Songgggggggg/FinalProject/(list of files, drawings)

Other design files:
PCB-0815.dip
