Songgggggggg/FinalProject/1_nrst.kicad_sch

## KiCad design 1_nrst.kicad_sch (2023-09-04)

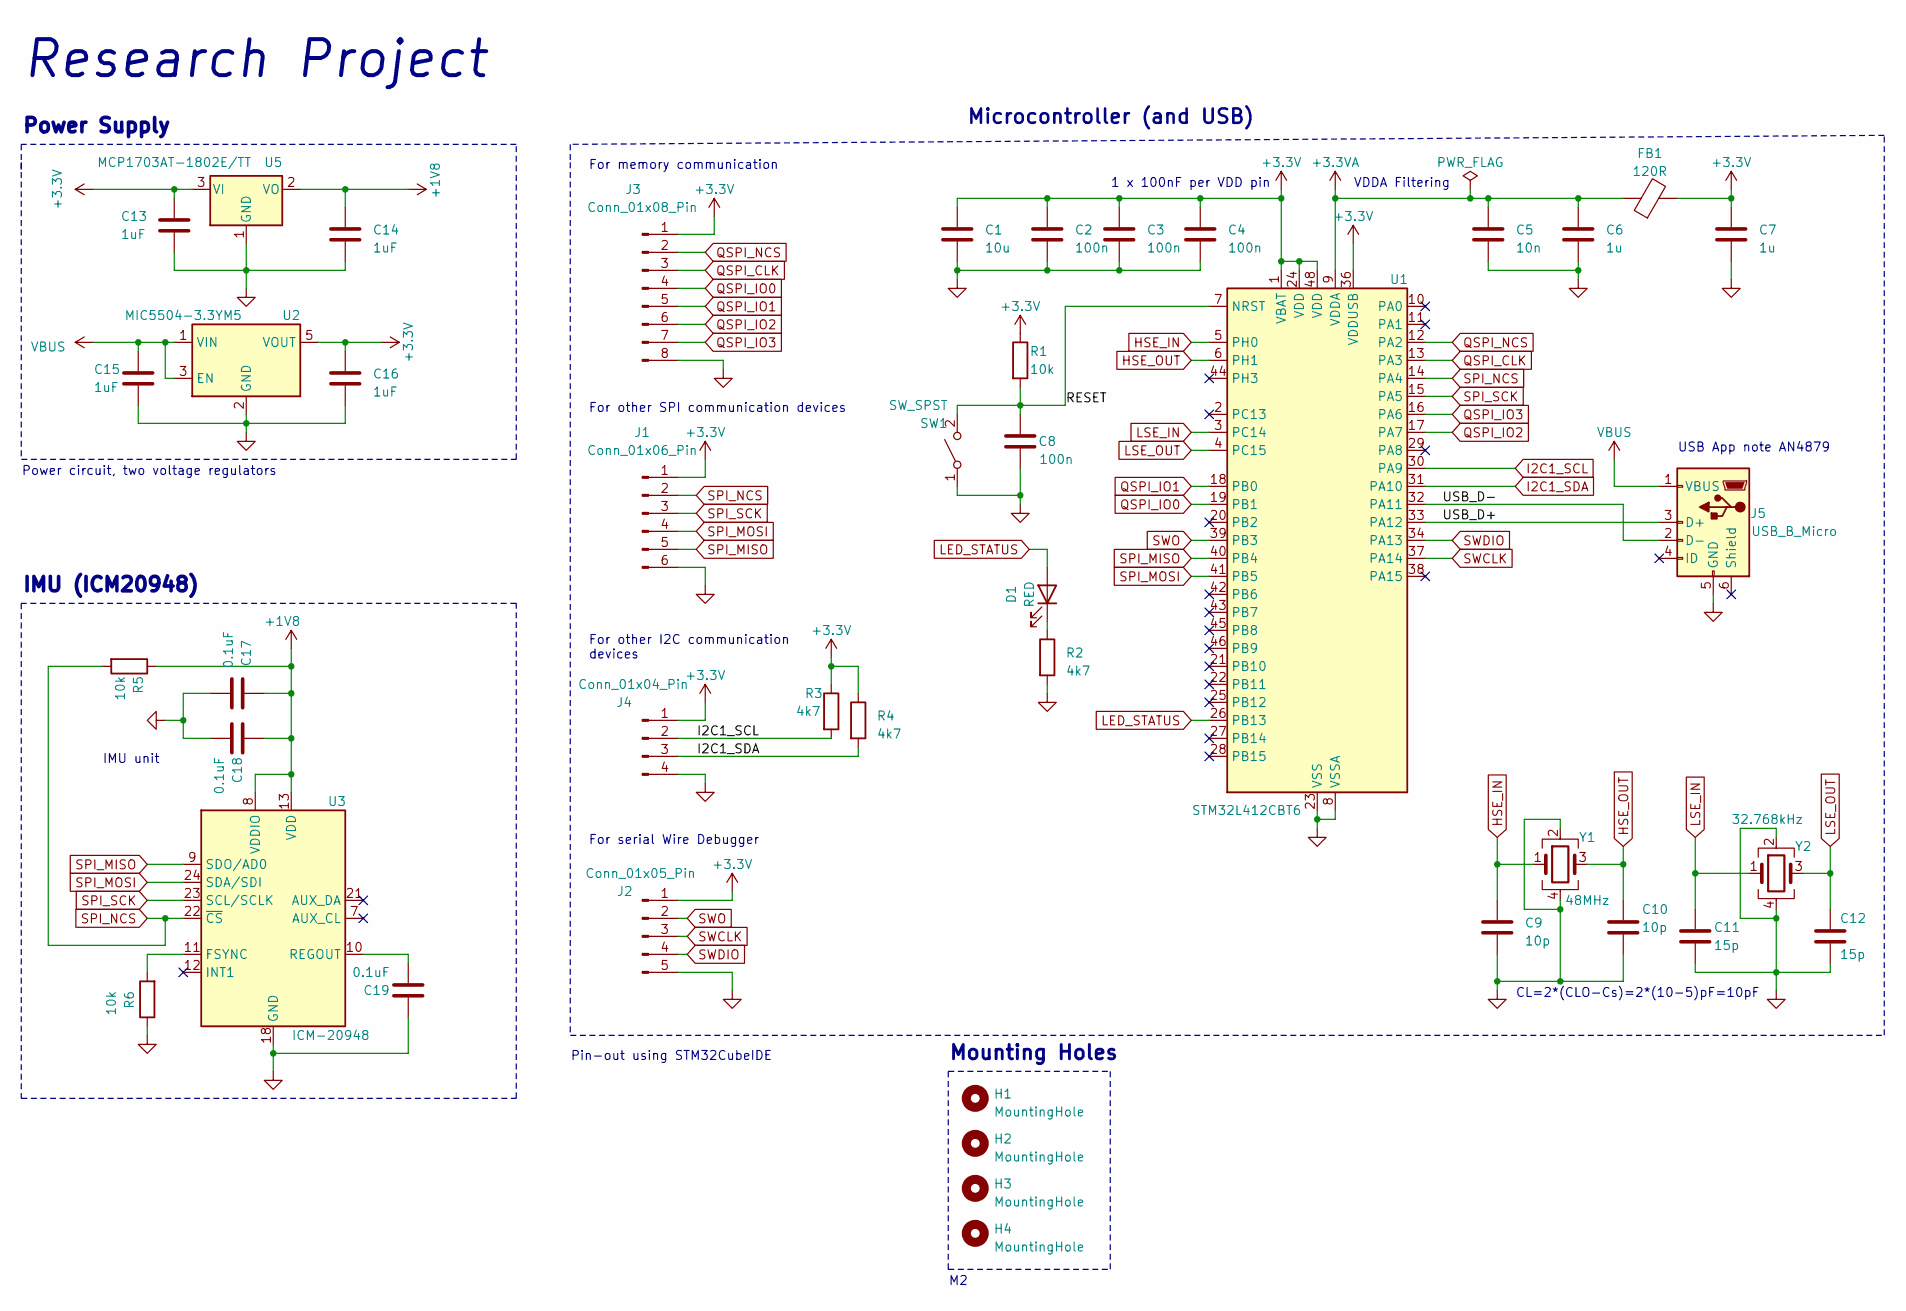
[picture p13: schematic 1_nrst.kicad_sch]

Parts:
C1: 10u; C_0603_1608Metric
C2, C3, C4, C8: 100n; C_0402_1005Metric
C5: 10n; C_0402_1005Metric
C6, C7: 1u; C_0402_1005Metric
C9, C10: 10p; C_0402_1005Metric
C11, C12: 15p; C_0402_1005Metric
C13, C14, C15, C16: 1uF; C_0805_2012Metric
C17, C18, C19: 0.1uF; C_0805_2012Metric
D1: RED; LED_0402_1005Metric
FB1: 120R; L_0603_1608Metric
H1, H2, H3, H4: MountingHole; MountingHole_2.2mm_M2
J1: Conn_01x06_Pin; PinHeader_1x06_P2.54mm_Vertical
J2: Conn_01x05_Pin; PinHeader_1x05_P2.54mm_Vertical
J3: Conn_01x08_Pin; PinHeader_1x08_P2.54mm_Vertical
J4: Conn_01x04_Pin; PinHeader_1x04_P2.54mm_Vertical
J5: USB_B_Micro; USB_Micro-B_Wuerth_629105150521
R1, R5, R6: 10k; R_0402_1005Metric
R2, R3, R4: 4k7; R_0402_1005Metric
SW1: SW_SPST; SW_SPST_PTS645
U1: STM32L412CBT6; LQFP-48_7x7mm_P0.5mm
U2: MIC5504-3.3YM5; SOT-23-5
U3: ICM-20948; InvenSense_QFN-24_3x3mm_P0.4mm
U5: MCP1703AT-1802E/TT; SOT-23
Y1: 48MHz; Crystal_SMD_3225-4Pin_3.2x2.5mm
Y2: 32.768kHz; Crystal_SMD_3225-4Pin_3.2x2.5mm

Connections:
+1V8: C14.1, C17.1, C18.1, R5.1, U3.8 (VDDIO), U3.13 (VDD), U5.2 (VO)
+3.3V: C1.1, C2.1, C3.1, C4.1, C7.1, C13.1, C16.1, FB1.2, J1.1, J2.1, J3.1, J4.1, R1.1, R3.1, R4.1, U1.1 (VBAT), U1.24 (VDD), U1.36 (VDDUSB), U1.48 (VDD), U2.5 (VOUT), U5.3 (VI)
+3.3VA: C5.1, C6.1, FB1.1, U1.9 (VDDA)
GND: C1.2, C2.2, C3.2, C4.2, C5.2, C6.2, C7.2, C8.2, C9.2, C10.2, C11.2, C12.2, C13.2, C14.2, C15.2, C16.2, C17.2, C18.2, C19.1, J1.6, J2.5, J3.8, J4.4, J5.5 (GND), R2.2, R6.1, SW1.1 (A), U1.8 (VSSA), U1.23 (VSS), U1.35 (VSS), U1.47 (VSS), U2.2 (GND), U3.18 (GND), U3.20 (GND), U5.1 (GND), Y1.2, Y1.4, Y2.2, Y2.4
HSE_IN: C9.1, U1.5 (PH0), Y1.1
HSE_OUT: C10.1, U1.6 (PH1), Y1.3
I2C1_SCL: J4.2, R3.2, U1.30 (PA9)
I2C1_SDA: J4.3, R4.2, U1.31 (PA10)
LED_STATUS: D1.2 (A), U1.26 (PB13)
LSE_IN: C11.1, U1.3 (PC14), Y2.1
LSE_OUT: C12.1, U1.4 (PC15), Y2.3
unnamed: C19.2, U3.10 (REGOUT)
unnamed: D1.1 (K), R2.1
unnamed: R6.2, U3.11 (FSYNC)
QSPI_CLK: J3.3, U1.13 (PA3)
QSPI_IO0: J3.4, U1.19 (PB1)
QSPI_IO1: J3.5, U1.18 (PB0)
QSPI_IO2: J3.6, U1.17 (PA7)
QSPI_IO3: J3.7, U1.16 (PA6)
QSPI_NCS: J3.2, U1.12 (PA2)
RESET: C8.1, R1.2, SW1.2 (B), U1.7 (NRST)
SPI_MISO: J1.5, U1.40 (PB4), U3.9 (SDO/AD0)
SPI_MOSI: J1.4, U1.41 (PB5), U3.24 (SDA/SDI)
SPI_NCS: J1.2, R5.2, U1.14 (PA4), U3.22 (~CS)
SPI_SCK: J1.3, U1.15 (PA5), U3.23 (SCL/SCLK)
SWCLK: J2.3, U1.37 (PA14)
SWDIO: J2.4, U1.34 (PA13)
SWO: J2.2, U1.39 (PB3)
USB_D+: J5.3 (D+), U1.33 (PA12)
USB_D-: J5.2 (D-), U1.32 (PA11)
VBUS: C15.1, J5.1 (VBUS), U2.1 (VIN), U2.3 (EN)

Notes on the sheet:
CL=2*(CLO-Cs)=2*(10-5)pF=10pF
For serial Wire Debugger
For memory communication
Research Project
Power circuit, two voltage regulators
USB App note AN4879
For other SPI communication devices
1 x 100nF per VDD pin
Pin-out using STM32CubeIDE
IMU unit
VDDA Filtering
Mounting Holes
Microcontroller (and USB)
IMU (ICM20948)
Power Supply
For other I2C communication devices
