Songgggggggg/FinalProject/Wearable_IMU_Device/MX25QL512/MX25QL512.ioc

Mcu.UserName=STM32L412RBTxP
PA10.Signal=I2C1_SDA
PA11.Signal=USB_DM
PA12.Signal=USB_DP
PA2.Signal=QUADSPI_BK1_NCS
PA3.Signal=QUADSPI_CLK
PA4.GPIO_Label=SPI1_CS
PA4.Signal=GPIO_Output
PA5.Signal=SPI1_SCK
PA6.Signal=QUADSPI_BK1_IO3
PA7.Signal=QUADSPI_BK1_IO2
PA9.Signal=I2C1_SCL
PB0.Signal=QUADSPI_BK1_IO1
PB1.Signal=QUADSPI_BK1_IO0
PB13.GPIO_Label=LED
PB13.Signal=GPIO_Output
PB5.Signal=SPI1_MOSI
