Songgggggggg/FinalProject/Wearable_IMU_Device/MX25QL512/Core/Src/quadspi.c

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
/* Includes ------------------------------------------------------------------*/
#include "quadspi.h"

/* USER CODE BEGIN 0 */
static uint8_t QSPI_WriteEnable(void);
static uint8_t QSPI_AutoPollingMemReady(uint32_t Timeout);
static uint8_t QSPI_Configuration(void);
static uint8_t QSPI_ResetChip(void);
/* USER CODE END 0 */

QSPI_HandleTypeDef hqspi;

/* QUADSPI init function */
void MX_QUADSPI_Init(void)
{

  hqspi.Instance = QUADSPI;
  hqspi.Init.ClockPrescaler = 0;
  hqspi.Init.FifoThreshold = 4;
  hqspi.Init.SampleShifting = QSPI_SAMPLE_SHIFTING_HALFCYCLE;
  hqspi.Init.FlashSize = 25;
  hqspi.Init.ChipSelectHighTime = QSPI_CS_HIGH_TIME_1_CYCLE;
  hqspi.Init.ClockMode = QSPI_CLOCK_MODE_0;
  hqspi.Init.FlashID = QSPI_FLASH_ID_1;
  hqspi.Init.DualFlash = QSPI_DUALFLASH_DISABLE;
  if (HAL_QSPI_Init(&hqspi) != HAL_OK)
  {
    Error_Handler();
  }
}

void HAL_QSPI_MspInit(QSPI_HandleTypeDef* qspiHandle)
{

  GPIO_InitTypeDef GPIO_InitStruct = {0};
  if(qspiHandle->Instance==QUADSPI)
  {
    /* QUADSPI clock enable */
    __HAL_RCC_QSPI_CLK_ENABLE();

    __HAL_RCC_GPIOA_CLK_ENABLE();
    __HAL_RCC_GPIOB_CLK_ENABLE();
    /**QUADSPI GPIO Configuration
    PA2     ------> QUADSPI_BK1_NCS
    PA3     ------> QUADSPI_CLK
    PA6     ------> QUADSPI_BK1_IO3
    PA7     ------> QUADSPI_BK1_IO2
    PB0     ------> QUADSPI_BK1_IO1
    PB1     ------> QUADSPI_BK1_IO0
    */
    GPIO_InitStruct.Pin = GPIO_PIN_2|GPIO_PIN_3|GPIO_PIN_6|GPIO_PIN_7;
    GPIO_InitStruct.Mode = GPIO_MODE_AF_PP;
    GPIO_InitStruct.Pull = GPIO_NOPULL;
    GPIO_InitStruct.Speed = GPIO_SPEED_FREQ_VERY_HIGH;
    GPIO_InitStruct.Alternate = GPIO_AF10_QUADSPI;
    HAL_GPIO_Init(GPIOA, &GPIO_InitStruct);

    GPIO_InitStruct.Pin = GPIO_PIN_0|GPIO_PIN_1;
    GPIO_InitStruct.Mode = GPIO_MODE_AF_PP;
    GPIO_InitStruct.Pull = GPIO_NOPULL;
    GPIO_InitStruct.Speed = GPIO_SPEED_FREQ_VERY_HIGH;
    GPIO_InitStruct.Alternate = GPIO_AF10_QUADSPI;
    HAL_GPIO_Init(GPIOB, &GPIO_InitStruct);

  }
}

void HAL_QSPI_MspDeInit(QSPI_HandleTypeDef* qspiHandle)
{

  if(qspiHandle->Instance==QUADSPI)
  {
    /* Peripheral clock disable */
    __HAL_RCC_QSPI_CLK_DISABLE();

    /**QUADSPI GPIO Configuration
    PA2     ------> QUADSPI_BK1_NCS
    PA3     ------> QUADSPI_CLK
    PA6     ------> QUADSPI_BK1_IO3
    PA7     ------> QUADSPI_BK1_IO2
    PB0     ------> QUADSPI_BK1_IO1
    PB1     ------> QUADSPI_BK1_IO0
    */
    HAL_GPIO_DeInit(GPIOA, GPIO_PIN_2|GPIO_PIN_3|GPIO_PIN_6|GPIO_PIN_7);

    HAL_GPIO_DeInit(GPIOB, GPIO_PIN_0|GPIO_PIN_1);

  }
}

/* USER CODE BEGIN 1 */


/* QUADSPI init function */
uint8_t
CSP_QUADSPI_Init(void) {
    //prepare QSPI peripheral for ST-Link Utility operations
	hqspi.Instance = QUADSPI;
    if (HAL_QSPI_DeInit(&hqspi) != HAL_OK) {
        return HAL_ERROR;
    }

    MX_QUADSPI_Init();

    if (QSPI_ResetChip() != HAL_OK) {
        return HAL_ERROR;
    }

    HAL_Delay(1);

    if (QSPI_AutoPollingMemReady(HAL_QPSI_TIMEOUT_DEFAULT_VALUE) != HAL_OK) {
        return HAL_ERROR;
    }

    if (QSPI_WriteEnable() != HAL_OK) {

        return HAL_ERROR;
    }

    if (QSPI_Configuration() != HAL_OK) {
        return HAL_ERROR;
    }

    if (QSPI_AutoPollingMemReady(HAL_QPSI_TIMEOUT_DEFAULT_VALUE) != HAL_OK) {
        return HAL_ERROR;
    }

    return HAL_OK;
}


/**
  * @brief Erases the entire QSPI chip.
  * @return HAL_OK if the operation is successful, otherwise HAL_ERROR.
  */
uint8_t CSP_QSPI_Erase_Chip(void) {
    QSPI_CommandTypeDef sCommand; // Structure to define commands for the QSPI.

    // Enable writing to the QSPI.
    if (QSPI_WriteEnable() != HAL_OK) {
        return HAL_ERROR;
    }

    // Setting up the erasing sequence.
    sCommand.Instruction = CHIP_ERASE_CMD; // Chip erase command.
    sCommand.InstructionMode = QSPI_INSTRUCTION_1_LINE; // Use one line for the instruction.
    sCommand.AddressSize = QSPI_ADDRESS_32_BITS; // Address size is 32 bits.
    sCommand.AlternateByteMode = QSPI_ALTERNATE_BYTES_NONE; // No alternate bytes.
    sCommand.DdrMode = QSPI_DDR_MODE_DISABLE; // DDR mode is disabled.
    sCommand.DdrHoldHalfCycle = QSPI_DDR_HHC_ANALOG_DELAY; // Hold half cycle.
    sCommand.SIOOMode = QSPI_SIOO_INST_EVERY_CMD; // Send instruction on every command.
    sCommand.AddressMode = QSPI_ADDRESS_NONE; // No address.
    sCommand.Address = 0; // No specific address.
    sCommand.DataMode = QSPI_DATA_NONE; // No data.
    sCommand.DummyCycles = 0; // No dummy cycles.

    // Send the command to erase the chip.
    if (HAL_QSPI_Command(&hqspi, &sCommand, HAL_QPSI_TIMEOUT_DEFAULT_VALUE) != HAL_OK) {
        return HAL_ERROR;
    }

    // Check and wait until the memory is ready after erasing.
    if (QSPI_AutoPollingMemReady(QUADSPI_MAX_ERASE_TIMEOUT) != HAL_OK) {
        return HAL_ERROR;
    }

    return HAL_OK;
}


static uint8_t
QSPI_AutoPollingMemReady(uint32_t Timeout) {

    QSPI_CommandTypeDef sCommand;
    QSPI_AutoPollingTypeDef sConfig;

    /* Configure automatic polling mode to wait for memory ready ------ */
    sCommand.InstructionMode = QSPI_INSTRUCTION_1_LINE;
    sCommand.Instruction = READ_STATUS_REG_CMD;
    sCommand.AddressMode = QSPI_ADDRESS_NONE;
    sCommand.AlternateByteMode = QSPI_ALTERNATE_BYTES_NONE;
    sCommand.DataMode = QSPI_DATA_1_LINE;
    sCommand.DummyCycles = 0;
    sCommand.DdrMode = QSPI_DDR_MODE_DISABLE;
    sCommand.DdrHoldHalfCycle = QSPI_DDR_HHC_ANALOG_DELAY;
    sCommand.SIOOMode = QSPI_SIOO_INST_EVERY_CMD;

    sConfig.Match = 0x0000;
    sConfig.Mask = 0x0101;
    sConfig.MatchMode = QSPI_MATCH_MODE_AND;
    sConfig.StatusBytesSize = 2;
    sConfig.Interval = 0x10;
    sConfig.AutomaticStop = QSPI_AUTOMATIC_STOP_ENABLE;

    if (HAL_QSPI_AutoPolling(&hqspi, &sCommand, &sConfig, Timeout) != HAL_OK) {
        return HAL_ERROR;
    }

    return HAL_OK;
}

static uint8_t
QSPI_WriteEnable(void) {
    QSPI_CommandTypeDef sCommand;
    QSPI_AutoPollingTypeDef sConfig;

    /* Enable write operations ------------------------------------------ */
    sCommand.InstructionMode = QSPI_INSTRUCTION_1_LINE;
    sCommand.Instruction = WRITE_ENABLE_CMD;
    sCommand.AddressMode = QSPI_ADDRESS_NONE;
    sCommand.AlternateByteMode = QSPI_ALTERNATE_BYTES_NONE;
    sCommand.DataMode = QSPI_DATA_NONE;
    sCommand.DummyCycles = 0;
    sCommand.DdrMode = QSPI_DDR_MODE_DISABLE;
    sCommand.DdrHoldHalfCycle = QSPI_DDR_HHC_ANALOG_DELAY;
    sCommand.SIOOMode = QSPI_SIOO_INST_EVERY_CMD;

    if (HAL_QSPI_Command(&hqspi, &sCommand, HAL_QPSI_TIMEOUT_DEFAULT_VALUE)
        != HAL_OK) {
        return HAL_ERROR;
    }

    /* Configure automatic polling mode to wait for write enabling ---- */
    sConfig.Match = 0x0202;
    sConfig.Mask = 0x0202;
    sConfig.MatchMode = QSPI_MATCH_MODE_AND;
    sConfig.StatusBytesSize = 2;
    sConfig.Interval = 0x10;
    sConfig.AutomaticStop = QSPI_AUTOMATIC_STOP_ENABLE;

    sCommand.Instruction = READ_STATUS_REG_CMD;
    sCommand.DataMode = QSPI_DATA_1_LINE;
    if (HAL_QSPI_AutoPolling(&hqspi, &sCommand, &sConfig,
                             HAL_QPSI_TIMEOUT_DEFAULT_VALUE) != HAL_OK) {
        return HAL_ERROR;
    }

    return HAL_OK;
}

/*Enable quad mode and set dummy cycles count*/
static uint8_t
QSPI_Configuration(void) {

    QSPI_CommandTypeDef sCommand;
    uint16_t reg;


    /*enter 4 byte address*/
    sCommand.InstructionMode = QSPI_INSTRUCTION_1_LINE;
    sCommand.Instruction = ENTER_4_BYTE_ADD_CMD;
    sCommand.AddressMode = QSPI_ADDRESS_NONE;
    sCommand.AlternateByteMode = QSPI_ALTERNATE_BYTES_NONE;
    sCommand.DataMode = QSPI_DATA_NONE;
    sCommand.DummyCycles = 0;
    sCommand.DdrMode = QSPI_DDR_MODE_DISABLE;
    sCommand.DdrHoldHalfCycle = QSPI_DDR_HHC_ANALOG_DELAY;
    sCommand.SIOOMode = QSPI_SIOO_INST_EVERY_CMD;
    sCommand.NbData = 0;

    if (HAL_QSPI_Command(&hqspi, &sCommand, HAL_QPSI_TIMEOUT_DEFAULT_VALUE)
        != HAL_OK) {
        return HAL_ERROR;
    }


    /*read configuration register*/
    sCommand.InstructionMode = QSPI_INSTRUCTION_1_LINE;
    sCommand.Instruction = READ_CONFIGURATION_REG_CMD;
    sCommand.AddressMode = QSPI_ADDRESS_NONE;
    sCommand.AlternateByteMode = QSPI_ALTERNATE_BYTES_NONE;
    sCommand.DataMode = QSPI_DATA_1_LINE;
    sCommand.DummyCycles = 0;
    sCommand.DdrMode = QSPI_DDR_MODE_DISABLE;
    sCommand.DdrHoldHalfCycle = QSPI_DDR_HHC_ANALOG_DELAY;
    sCommand.SIOOMode = QSPI_SIOO_INST_EVERY_CMD;
    sCommand.NbData = 2;

    if (HAL_QSPI_Command(&hqspi, &sCommand, HAL_QPSI_TIMEOUT_DEFAULT_VALUE)
        != HAL_OK) {
        return HAL_ERROR;
    }


    if (HAL_QSPI_Receive(&hqspi, (uint8_t*)(&reg),
                         HAL_QPSI_TIMEOUT_DEFAULT_VALUE) != HAL_OK) {
        return HAL_ERROR;
    }



    if (QSPI_WriteEnable() != HAL_OK) {

        return HAL_ERROR;
    }


    /*set dummy cycles*/
    MODIFY_REG(reg, 0xF0F0, ((DUMMY_CLOCK_CYCLES_READ_QUAD << 4) |
                             (DUMMY_CLOCK_CYCLES_READ_QUAD << 12)));


    sCommand.Instruction = WRITE_VOL_CFG_REG_CMD;


    if (HAL_QSPI_Command(&hqspi, &sCommand, HAL_QPSI_TIMEOUT_DEFAULT_VALUE)
        != HAL_OK) {
        return HAL_ERROR;
    }

    if (HAL_QSPI_Transmit(&hqspi, (uint8_t*)(&reg),
                          HAL_QPSI_TIMEOUT_DEFAULT_VALUE) != HAL_OK) {
        return HAL_ERROR;
    }
    return HAL_OK;
}

/**
  * @brief Erases sectors from QSPI memory.
  * @param EraseStartAddress The starting address of the sector to be erased.
  * @param EraseEndAddress The ending address of the sector to be erased.
  * @return HAL_OK if the operation is successful, otherwise HAL_ERROR.
  */
uint8_t CSP_QSPI_EraseSector(uint32_t EraseStartAddress, uint32_t EraseEndAddress) {
    QSPI_CommandTypeDef sCommand; // Structure to define commands for the QSPI.

    // Align the start address to the beginning of a sector.
    EraseStartAddress = EraseStartAddress - EraseStartAddress % MEMORY_SECTOR_SIZE;

    // Setting up the erasing sequence.
    sCommand.InstructionMode = QSPI_INSTRUCTION_1_LINE; // Use one line for the instruction.
    sCommand.AddressSize = QSPI_ADDRESS_32_BITS; // Address size is 32 bits.
    sCommand.AlternateByteMode = QSPI_ALTERNATE_BYTES_NONE; // No alternate bytes.
    sCommand.DdrMode = QSPI_DDR_MODE_DISABLE; // DDR mode is disabled.
    sCommand.DdrHoldHalfCycle = QSPI_DDR_HHC_ANALOG_DELAY; // Hold half cycle.
    sCommand.SIOOMode = QSPI_SIOO_INST_EVERY_CMD; // Send instruction on every command.
    sCommand.Instruction = SECTOR_ERASE_CMD; // Sector erase command.
    sCommand.AddressMode = QSPI_ADDRESS_1_LINE; // Use one line for the address.
    sCommand.DataMode = QSPI_DATA_NONE; // No data.
    sCommand.DummyCycles = 0; // No dummy cycles.

    // Loop until all sectors between start and end addresses are erased.
    while (EraseEndAddress >= EraseStartAddress) {
        sCommand.Address = (EraseStartAddress & 0x0FFFFFFF); // Ensure only valid address bits are used.

        // Enable writing to the QSPI.
        if (QSPI_WriteEnable() != HAL_OK) {
            return HAL_ERROR;
        }

        // Send the command to erase the sector.
        if (HAL_QSPI_Command(&hqspi, &sCommand, HAL_QPSI_TIMEOUT_DEFAULT_VALUE) != HAL_OK) {
            return HAL_ERROR;
        }

        // Move to the next sector.
        EraseStartAddress += MEMORY_SECTOR_SIZE;

        // Check and wait until the memory is ready after erasing.
        if (QSPI_AutoPollingMemReady(HAL_QPSI_TIMEOUT_DEFAULT_VALUE) != HAL_OK) {
            return HAL_ERROR;
        }
    }

    return HAL_OK;
}


/**
  * @brief Writes data to QSPI memory.
  * @param buffer Pointer to the data buffer to be written.
  * @param address Start address in the QSPI memory where data is to be written.
  * @param buffer_size Size of the data buffer.
  * @return HAL_OK if the operation is successful, otherwise HAL_ERROR.
  */
uint8_t CSP_QSPI_WriteMemory(uint8_t* buffer, uint32_t address, uint32_t buffer_size) {
    QSPI_CommandTypeDef sCommand;  // Structure to define commands for the QSPI.
    uint32_t end_addr, current_size, current_addr;

    // Compute the size between the write address and the end of the page.
    current_addr = 0;
    while (current_addr <= address) {
        current_addr += MEMORY_PAGE_SIZE;
    }
    current_size = current_addr - address;

    // Check if data size is less than the remaining space in the page.
    if (current_size > buffer_size) {
        current_size = buffer_size;
    }

    // Initialize address variables.
    current_addr = address;
    end_addr = address + buffer_size;

    // Initialize command parameters.
    sCommand.InstructionMode = QSPI_INSTRUCTION_1_LINE;
    sCommand.AddressSize = QSPI_ADDRESS_32_BITS;
    sCommand.AlternateByteMode = QSPI_ALTERNATE_BYTES_NONE;
    sCommand.DdrMode = QSPI_DDR_MODE_DISABLE;
    sCommand.DdrHoldHalfCycle = QSPI_DDR_HHC_ANALOG_DELAY;
    sCommand.SIOOMode = QSPI_SIOO_INST_EVERY_CMD;
    sCommand.Instruction = QUAD_IN_FAST_PROG_CMD;
    sCommand.AddressMode = QSPI_ADDRESS_1_LINE;
    sCommand.DataMode = QSPI_DATA_4_LINES;
    sCommand.NbData = buffer_size;
    sCommand.Address = address;
    sCommand.DummyCycles = 0;

    // Write data page by page.
    do {
        sCommand.Address = current_addr;
        sCommand.NbData = current_size;

        // If current size is 0, the operation is done.
        if (current_size == 0) {
            return HAL_OK;
        }

        // Enable write operations.
        if (QSPI_WriteEnable() != HAL_OK) {
            return HAL_ERROR;
        }

        // Send the write command.
        if (HAL_QSPI_Command(&hqspi, &sCommand, HAL_QPSI_TIMEOUT_DEFAULT_VALUE) != HAL_OK) {
            return HAL_ERROR;
        }

        // Transmit the data.
        if (HAL_QSPI_Transmit(&hqspi, buffer, HAL_QPSI_TIMEOUT_DEFAULT_VALUE) != HAL_OK) {
            return HAL_ERROR;
        }

        // Use automatic polling mode to wait for program completion.
        if (QSPI_AutoPollingMemReady(HAL_QPSI_TIMEOUT_DEFAULT_VALUE) != HAL_OK) {
            return HAL_ERROR;
        }

        // Update the address and size for next page programming.
        current_addr += current_size;
        buffer += current_size;
        current_size = ((current_addr + MEMORY_PAGE_SIZE) > end_addr) ? 
                        (end_addr - current_addr) : MEMORY_PAGE_SIZE;
    } while (current_addr <= end_addr);

    return HAL_OK;
}



uint8_t
CSP_QSPI_EnableMemoryMappedMode(void) {

    QSPI_CommandTypeDef sCommand;
    QSPI_MemoryMappedTypeDef sMemMappedCfg;

    /* Enable Memory-Mapped mode-------------------------------------------------- */

    sCommand.InstructionMode = QSPI_INSTRUCTION_1_LINE;
    sCommand.AddressSize = QSPI_ADDRESS_32_BITS;
    sCommand.AlternateByteMode = QSPI_ALTERNATE_BYTES_NONE;
    sCommand.DdrMode = QSPI_DDR_MODE_DISABLE;
    sCommand.DdrHoldHalfCycle = QSPI_DDR_HHC_ANALOG_DELAY;
    sCommand.SIOOMode = QSPI_SIOO_INST_EVERY_CMD;
    sCommand.AddressMode = QSPI_ADDRESS_1_LINE;
    sCommand.DataMode = QSPI_DATA_4_LINES;
    sCommand.NbData = 0;
    sCommand.Address = 0;
    sCommand.Instruction = QUAD_OUT_FAST_READ_CMD;
    sCommand.DummyCycles = DUMMY_CLOCK_CYCLES_READ_QUAD;

    sMemMappedCfg.TimeOutActivation = QSPI_TIMEOUT_COUNTER_DISABLE;

    if (HAL_QSPI_MemoryMapped(&hqspi, &sCommand, &sMemMappedCfg) != HAL_OK) {
        return HAL_ERROR;
    }
    return HAL_OK;
}

static uint8_t
QSPI_ResetChip() {
    QSPI_CommandTypeDef sCommand;
    uint32_t temp = 0;
    /* Erasing Sequence -------------------------------------------------- */
    sCommand.InstructionMode = QSPI_INSTRUCTION_1_LINE;
    sCommand.AddressSize = QSPI_ADDRESS_24_BITS;
    sCommand.AlternateByteMode = QSPI_ALTERNATE_BYTES_NONE;
    sCommand.DdrMode = QSPI_DDR_MODE_DISABLE;
    sCommand.DdrHoldHalfCycle = QSPI_DDR_HHC_ANALOG_DELAY;
    sCommand.SIOOMode = QSPI_SIOO_INST_EVERY_CMD;
    sCommand.Instruction = RESET_ENABLE_CMD;
    sCommand.AddressMode = QSPI_ADDRESS_NONE;
    sCommand.Address = 0;
    sCommand.DataMode = QSPI_DATA_NONE;
    sCommand.DummyCycles = 0;

    if (HAL_QSPI_Command(&hqspi, &sCommand, HAL_QPSI_TIMEOUT_DEFAULT_VALUE)
        != HAL_OK) {
        return HAL_ERROR;
    }
    for (temp = 0; temp < 0x2f; temp++) {
        __NOP();
    }

    sCommand.InstructionMode = QSPI_INSTRUCTION_1_LINE;
    sCommand.AddressSize = QSPI_ADDRESS_24_BITS;
    sCommand.AlternateByteMode = QSPI_ALTERNATE_BYTES_NONE;
    sCommand.DdrMode = QSPI_DDR_MODE_DISABLE;
    sCommand.DdrHoldHalfCycle = QSPI_DDR_HHC_ANALOG_DELAY;
    sCommand.SIOOMode = QSPI_SIOO_INST_EVERY_CMD;
    sCommand.Instruction = RESET_EXECUTE_CMD;
    sCommand.AddressMode = QSPI_ADDRESS_NONE;
    sCommand.Address = 0;
    sCommand.DataMode = QSPI_DATA_NONE;
    sCommand.DummyCycles = 0;

    if (HAL_QSPI_Command(&hqspi, &sCommand, HAL_QPSI_TIMEOUT_DEFAULT_VALUE)
        != HAL_OK) {
        return HAL_ERROR;
    }

    /* Erasing Sequence -------------------------------------------------- */
    sCommand.InstructionMode = QSPI_INSTRUCTION_2_LINES;
    sCommand.AddressSize = QSPI_ADDRESS_24_BITS;
    sCommand.AlternateByteMode = QSPI_ALTERNATE_BYTES_NONE;
    sCommand.DdrMode = QSPI_DDR_MODE_DISABLE;
    sCommand.DdrHoldHalfCycle = QSPI_DDR_HHC_ANALOG_DELAY;
    sCommand.SIOOMode = QSPI_SIOO_INST_EVERY_CMD;
    sCommand.Instruction = RESET_ENABLE_CMD;
    sCommand.AddressMode = QSPI_ADDRESS_NONE;
    sCommand.Address = 0;
    sCommand.DataMode = QSPI_DATA_NONE;
    sCommand.DummyCycles = 0;

    if (HAL_QSPI_Command(&hqspi, &sCommand, HAL_QPSI_TIMEOUT_DEFAULT_VALUE)
        != HAL_OK) {
        return HAL_ERROR;
    }
    for (temp = 0; temp < 0x2f; temp++) {
        __NOP();
    }

    sCommand.InstructionMode = QSPI_INSTRUCTION_2_LINES;
    sCommand.AddressSize = QSPI_ADDRESS_24_BITS;
    sCommand.AlternateByteMode = QSPI_ALTERNATE_BYTES_NONE;
    sCommand.DdrMode = QSPI_DDR_MODE_DISABLE;
    sCommand.DdrHoldHalfCycle = QSPI_DDR_HHC_ANALOG_DELAY;
    sCommand.SIOOMode = QSPI_SIOO_INST_EVERY_CMD;
    sCommand.Instruction = RESET_EXECUTE_CMD;
    sCommand.AddressMode = QSPI_ADDRESS_NONE;
    sCommand.Address = 0;
    sCommand.DataMode = QSPI_DATA_NONE;
    sCommand.DummyCycles = 0;

    if (HAL_QSPI_Command(&hqspi, &sCommand, HAL_QPSI_TIMEOUT_DEFAULT_VALUE)
        != HAL_OK) {
        return HAL_ERROR;
    }

    /* Erasing Sequence -------------------------------------------------- */
    sCommand.InstructionMode = QSPI_INSTRUCTION_4_LINES;
    sCommand.AddressSize = QSPI_ADDRESS_24_BITS;
    sCommand.AlternateByteMode = QSPI_ALTERNATE_BYTES_NONE;
    sCommand.DdrMode = QSPI_DDR_MODE_DISABLE;
    sCommand.DdrHoldHalfCycle = QSPI_DDR_HHC_ANALOG_DELAY;
    sCommand.SIOOMode = QSPI_SIOO_INST_EVERY_CMD;
    sCommand.Instruction = RESET_ENABLE_CMD;
    sCommand.AddressMode = QSPI_ADDRESS_NONE;
    sCommand.Address = 0;
    sCommand.DataMode = QSPI_DATA_NONE;
    sCommand.DummyCycles = 0;

    if (HAL_QSPI_Command(&hqspi, &sCommand, HAL_QPSI_TIMEOUT_DEFAULT_VALUE)
        != HAL_OK) {
        return HAL_ERROR;
    }
    for (temp = 0; temp < 0x2f; temp++) {
        __NOP();
    }

    sCommand.InstructionMode = QSPI_INSTRUCTION_4_LINES;
    sCommand.AddressSize = QSPI_ADDRESS_24_BITS;
    sCommand.AlternateByteMode = QSPI_ALTERNATE_BYTES_NONE;
    sCommand.DdrMode = QSPI_DDR_MODE_DISABLE;
    sCommand.DdrHoldHalfCycle = QSPI_DDR_HHC_ANALOG_DELAY;
    sCommand.SIOOMode = QSPI_SIOO_INST_EVERY_CMD;
    sCommand.Instruction = RESET_EXECUTE_CMD;
    sCommand.AddressMode = QSPI_ADDRESS_NONE;
    sCommand.Address = 0;
    sCommand.DataMode = QSPI_DATA_NONE;
    sCommand.DummyCycles = 0;

    if (HAL_QSPI_Command(&hqspi, &sCommand, HAL_QPSI_TIMEOUT_DEFAULT_VALUE)
        != HAL_OK) {
        return HAL_ERROR;
    }

    return HAL_OK;
}

/**
  * @brief Reads data from QSPI memory.
  * @param pData Pointer to the buffer that will receive the data.
  * @param ReadAddr Address from which data will be read.
  * @param Size Number of data bytes to be read.
  * @return HAL_OK if the operation is successful, otherwise HAL_ERROR.
  */
uint8_t CSP_QSPI_Read(uint8_t* pData, uint32_t ReadAddr, uint32_t Size) {
    QSPI_CommandTypeDef s_command;  // Structure to define commands for the QSPI.

    // Initialize the read command parameters.
    s_command.InstructionMode   = QSPI_INSTRUCTION_1_LINE;         // Use one line for the instruction.
    s_command.Instruction       = QUAD_OUT_FAST_READ_CMD;          // Fast read command.
    s_command.AddressMode       = QSPI_ADDRESS_4_LINES;            // Use four lines for the address.
    s_command.AddressSize       = QSPI_ADDRESS_24_BITS;            // Address size is 24 bits.
    s_command.Address           = ReadAddr;                        // Address to start reading from.
    s_command.AlternateByteMode = QSPI_ALTERNATE_BYTES_NONE;       // No alternate bytes.
    s_command.DataMode          = QSPI_DATA_4_LINES;               // Use four lines for data.
    s_command.DummyCycles       = DUMMY_CLOCK_CYCLES_READ_QUAD;    // Number of dummy cycles for the read operation.
    s_command.NbData            = Size;                            // Number of data bytes to be read.
    s_command.DdrMode           = QSPI_DDR_MODE_DISABLE;           // DDR mode is disabled.
    s_command.DdrHoldHalfCycle  = QSPI_DDR_HHC_ANALOG_DELAY;       // Hold half cycle.
    s_command.SIOOMode          = QSPI_SIOO_INST_EVERY_CMD;        // Send instruction on every command.

    // Send the read command.
    if (HAL_QSPI_Command(&hqspi, &s_command, HAL_QPSI_TIMEOUT_DEFAULT_VALUE) != HAL_OK) {
        return HAL_ERROR;
    }

    // Adjust the Chip Select timing for Read command.
    MODIFY_REG(hqspi.Instance->DCR, QUADSPI_DCR_CSHT, QSPI_CS_HIGH_TIME_3_CYCLE);

    // Receive the data.
    if (HAL_QSPI_Receive(&hqspi, pData, HAL_QPSI_TIMEOUT_DEFAULT_VALUE) != HAL_OK) {
        return HAL_ERROR;
    }

    // Restore the Chip Select timing for non-Read commands.
    MODIFY_REG(hqspi.Instance->DCR, QUADSPI_DCR_CSHT, QSPI_CS_HIGH_TIME_6_CYCLE);

    return HAL_OK;
}

/* USER CODE END 1 */
