Songgggggggg/FinalProject/(commit log)

2023-09-04 Add files via upload
    KiCAD Schematics and PCB
    [1_nrst.kicad_sch, PCB-0815.dip]
2023-09-06 update cubeide
    [data_20230812_220034.csv, data_20230812_221007.csv, data_20230812_221216.csv, data_20230812_222101.csv, data_20230812_224619.csv, data_20230812_224845.csv, data_20230812_225105.csv, data_20230812_225156.csv]
