Songgggggggg/FinalProject/(notices)

Notices in the files:
Wearable_IMU_Device/MX25QL512/Core/Src/quadspi.c:
Copyright (c) 2023 STMicroelectronics.
All rights reserved.
This software is licensed under terms that can be found in the LICENSE file
